jonileungck/eecs149_project/software/apps/app_timer_example/README.md

Timer
=====

Example of how to use app_timer
Toggles LED0 1 second after pressing the button
