jonileungck/eecs149_project/ultrasonic_CADs/reflector_top.SLDPRT

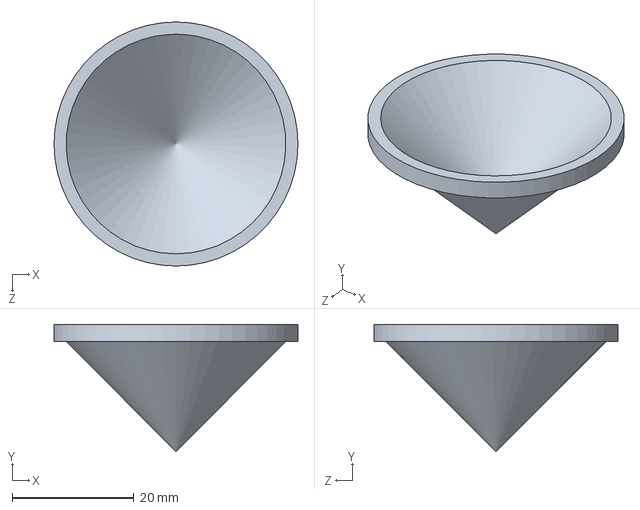
[picture p3: CAD file, 2018-11-06]
ultrasonic_CADs/reflector_top.SLDPRT
40.0 x 20.8 x 40.0 mm
