jonileungck/eecs149_project/ultrasonic_CADs/reflector_rod.SLDPRT

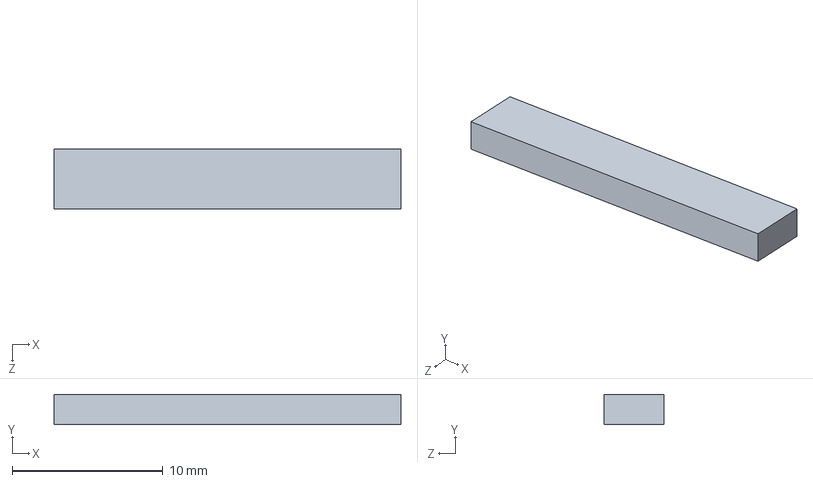
[picture p4: CAD file, 2018-11-06]
ultrasonic_CADs/reflector_rod.SLDPRT
23.0 x 2.00 x 4.00 mm
