jonileungck/eecs149_project/ultrasonic_CADs/reflector_bottom.SLDPRT

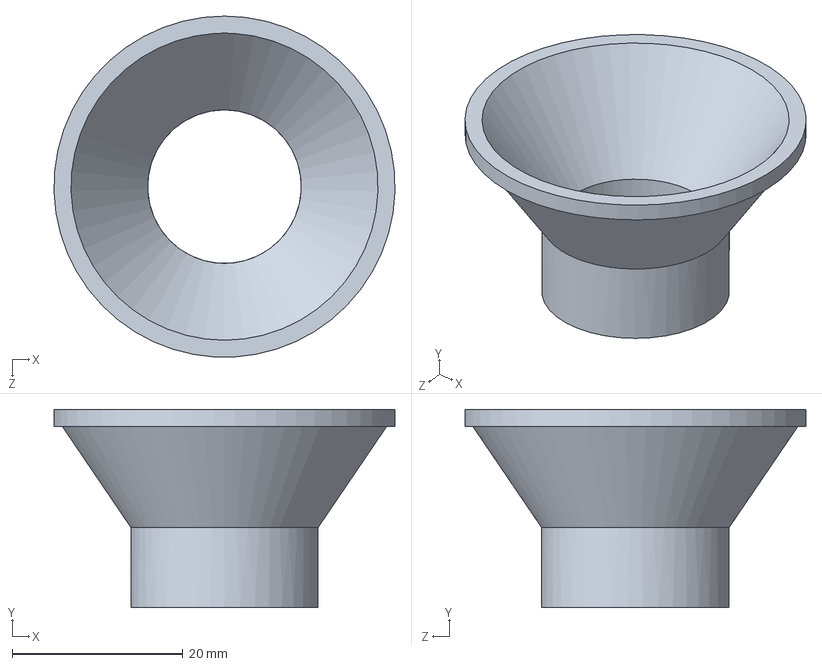
[picture p5: CAD file, 2018-11-06]
ultrasonic_CADs/reflector_bottom.SLDPRT
40.0 x 23.2 x 40.0 mm
