jonileungck/eecs149_project/ultrasonic_CADs/reflector.SLDPRT

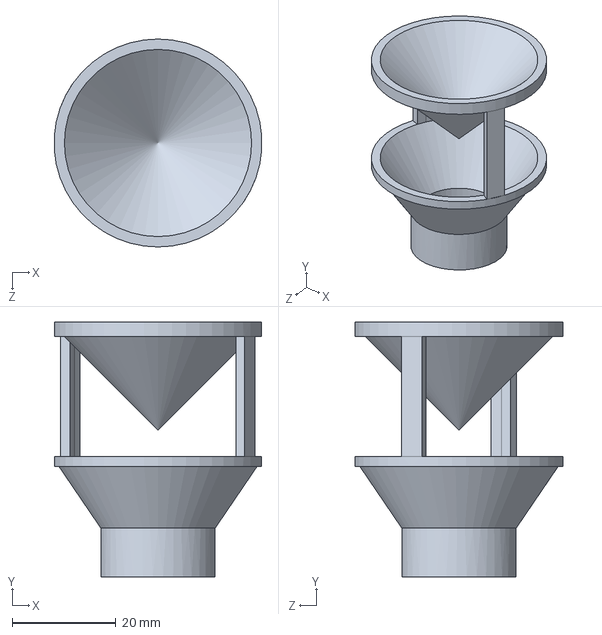
[picture p6: CAD file, 2018-11-05]
ultrasonic_CADs/reflector.SLDPRT
39.9 x 49.1 x 40.0 mm
