jonileungck/eecs149_project/(list of files, cad)

Other CAD files:
ultrasonic_CADs/reflector.STL
ultrasonic_CADs/reflector_bottom.STL
ultrasonic_CADs/reflector_rod.STL
ultrasonic_CADs/reflector_top.STL
