jonileungck/eecs149_project/software/apps/wireless/ble_rx/main.c

// BLE RX app
//
// Receives BLE advertisements with data

#include <stdbool.h>
#include <stdint.h>
#include "nrf.h"
#include "app_util.h"
#include "simple_ble.h"

// BLE configuration
// This is mostly irrelevant since we are scanning only
static simple_ble_config_t ble_config = {
        // BLE address is c0:98:e5:49:00:02
        .platform_id       = 0x4A,    // used as 4th octet in device BLE address
        .device_id         = 0x0002,  // used as the 5th and 6th octet in the device BLE address, you will need to change this for each device you have
        .adv_name          = "EE149", // irrelevant in this example
        .adv_interval      = MSEC_TO_UNITS(1000, UNIT_0_625_MS), // send a packet once per second (minimum is 20 ms)
        .min_conn_interval = MSEC_TO_UNITS(500, UNIT_1_25_MS), // irrelevant if advertising only
        .max_conn_interval = MSEC_TO_UNITS(1000, UNIT_1_25_MS), // irrelevant if advertising only
};
simple_ble_app_t* simple_ble_app;

void ble_evt_adv_report(ble_evt_t const* p_ble_evt) {

  // extract the fields we care about
  ble_gap_evt_adv_report_t const* adv_report = &(p_ble_evt->evt.gap_evt.params.adv_report);
  uint8_t const* ble_addr = adv_report->peer_addr.addr;
  uint8_t* adv_buf = adv_report->data.p_data;
  uint16_t adv_len = adv_report->data.len;

  // print the BLE address of the device
  //printf("BLE Address: %X%X%X%X%X%X\n", ble_addr[5], ble_addr[4], ble_addr[3], ble_addr[2], ble_addr[1], ble_addr[0]);
  if (ble_addr[5] == 0xC0 && ble_addr[4] == 0x98 && ble_addr[3] == 0xE5 && ble_addr[2] == 0x4A) {

    // print advertisement data
    // Note: the payload data we provided in the BLE TX Example starts at byte 8
    printf("data: [");
    for (int i=8; i<adv_len; i++) {
      if(i == 8) {
        printf("%u", adv_buf[i]);
      } else {
        printf(", %u", adv_buf[i]);
      }
    }
    printf("]\n");
  }
}


int main(void) {

  // Setup BLE
  // Note: simple BLE is our own library. You can find it in `nrf5x-base/lib/simple_ble/`
  simple_ble_app = simple_ble_init(&ble_config);
  advertising_stop();

  printf("Scanning Start");

  // Start scanning
  scanning_start();
  printf("Scanning Start");


  // go into low power mode
  while(1) {
    power_manage();
  }
}
