jonileungck/eecs149_project/software/apps/ultrasonic/demo.c

#include <stdbool.h>
#include <stdint.h>
#include <stdio.h>

#include "app_error.h"
#include "app_timer.h"
#include "nrf.h"
#include "nrf_delay.h"
#include "nrf_log.h"
#include "nrf_gpio.h"
#include "nrf_log_ctrl.h"
#include "nrf_log_default_backends.h"
#include "nrf_pwr_mgmt.h"
#include "nrf_serial.h"
#include "software_interrupt.h"
//#include "gpio.h"

#include "buckler.h"

// LED = pin 25, 24, 23

static int times = 0;

void SWI1_EGU1_IRQHandler(void) {
    NRF_EGU1->EVENTS_TRIGGERED[0] = 0;
}

void GPIOTE_IRQHandler(void) {
    NRF_GPIOTE->EVENTS_IN[0] = 0;
	nrf_delay_ms(40);
	printf("Ultrasonic detected %i\n", times);
	times += 1;
    nrf_gpio_pin_toggle(BUCKLER_LED0);
}

int main(void) {
  ret_code_t error_code = NRF_SUCCESS;

  // initialize RTT library
  error_code = NRF_LOG_INIT(NULL);
  APP_ERROR_CHECK(error_code);
  NRF_LOG_DEFAULT_BACKENDS_INIT();
  printf("Log initialized!\n");

  //gpio_config(25, OUTPUT);
  nrf_gpio_pin_dir_set(BUCKLER_LED0, NRF_GPIO_PIN_DIR_OUTPUT);

  //NRF_GPIOTE->CONFIG[0] = 0x21c01;
  NRF_GPIOTE->CONFIG[0] = 0x10401;
  NRF_GPIOTE->INTENSET = 1;
  NVIC_EnableIRQ(GPIOTE_IRQn);

  // loop forever
  while (1) {
    nrf_delay_ms(500);
  }
}
