jonileungck/eecs149_project/(commit log)

2018-10-29 starter servo driver code
2018-11-03 3d printing
    [reflector.SLDPRT, reflector.STL]
2018-11-05 reset 3D printer
2018-11-05 redesigned cone
    [reflector.SLDPRT, reflector.STL]
2018-11-06 added servo control support
2018-11-06 more gcodes... now 3D printing in separate pieces
    [reflector_bottom.SLDPRT, reflector_bottom.STL, reflector_rod.SLDPRT, reflector_rod.STL, reflector_top.SLDPRT, reflector_top.STL]
2018-11-06 house keeping
    [reflector.SLDPRT, reflector.STL, reflector_bottom.SLDPRT, reflector_bottom.STL, reflector_rod.SLDPRT, reflector_rod.STL, reflector_top.SLDPRT, reflector_top.STL]
2018-11-06 ultrasonic timer and interrupts
2018-11-07 reorganized ultrasonic
    [reflector.SLDPRT, reflector.STL, reflector_bottom.SLDPRT, reflector_bottom.STL, reflector_rod.SLDPRT, reflector_rod.STL, reflector_top.SLDPRT, reflector_top.STL]
2018-11-07 ultrasonic ready to flash
2018-11-07 using GPIO driver
2018-11-08 timer driver sucks
2018-11-08 ultrasonic works now
2018-11-14 app timer example
2018-11-14 hopefullt ultrasonic fixed
2018-11-14 enabled pull-down resistors for all ultrasonic input pins
2018-11-14 ultrasonic clean up
2018-11-15 tof sensor debugging
2018-11-15 calculate angle now prints debug
2018-11-15 ultrasonic now print angle instead of detection time
2018-11-21 tof sensor reads value
2018-11-21 vl53l1x driver + implementation
2018-11-21 Ultrasonic angle calculater will p r o b a b l y work
2018-12-04 fixed request blocked by origin policy
    [main.c]
2018-12-04 fixed http response header
    [main.c]
2018-12-05 use timer interrupt instead of inf loop
2018-12-05 clean up servo driver
2018-12-09 multiple sensors
2018-12-09 implemented avoid. Haven't tested
    [app_config.h, main.c]
2018-12-10 tof driver
2018-12-10 tof driver function
2018-12-10 tof driver integrated partially
2018-12-11 move data-transfer and visualizer into wireless app
